maziac/lagmeter/Docs/Case.md

# Case

For the case a calculator like box with space for an LCD display has been chosen.
The buttons have been placed on the top.
An USB-A connector is included for power supply and to flash the device.
Instead an independent power 5V power supply can be attached.
Furthermore the USB host connector has been placed in the front to connect an USB joystick.

In the back the cables and the phot sensor can be packed.

In order to fit everything in the USB connector and the power supply connector have been removed from the Arduino.
The USB connector on the USB shield has been left there. In parallel wires have been connected to a connector in the front.

The labelling was done with a SW called FrontDesign. You find it [here](../HW/Panel.pfd).

# Hint

Use a white or gray case instead of a black one.
The labeling will be much easier because you can print black on a transparent foil with a laser printer.

# Finalized

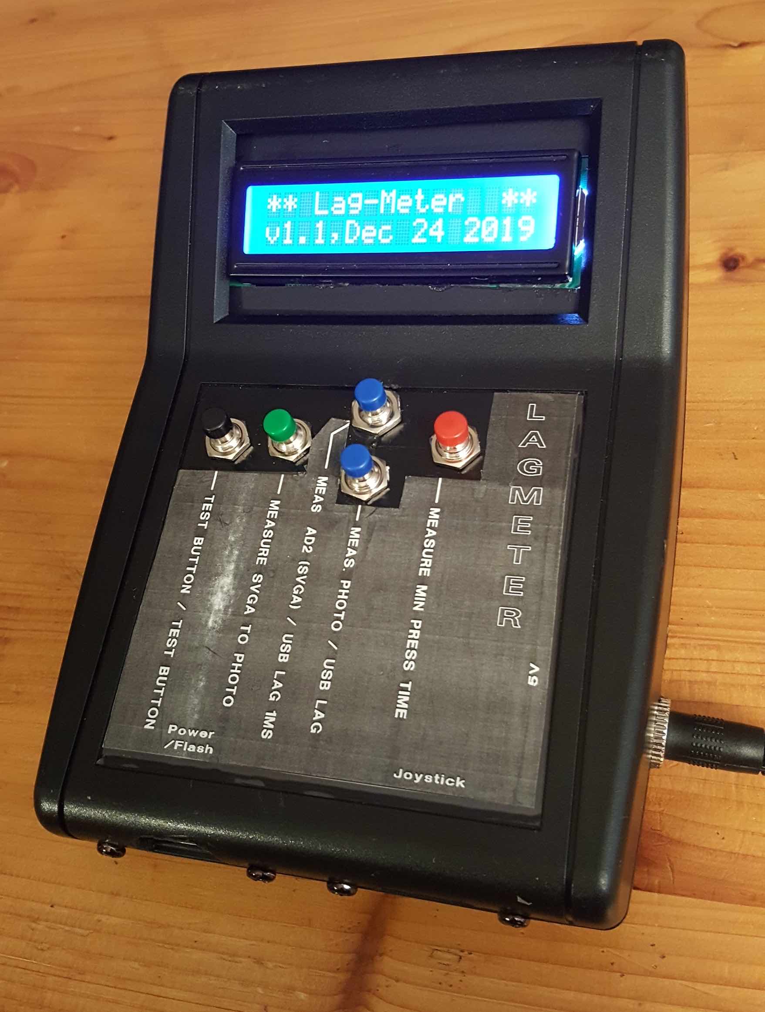
[picture p13: Docs/Images/Case/case_total1.jpg]

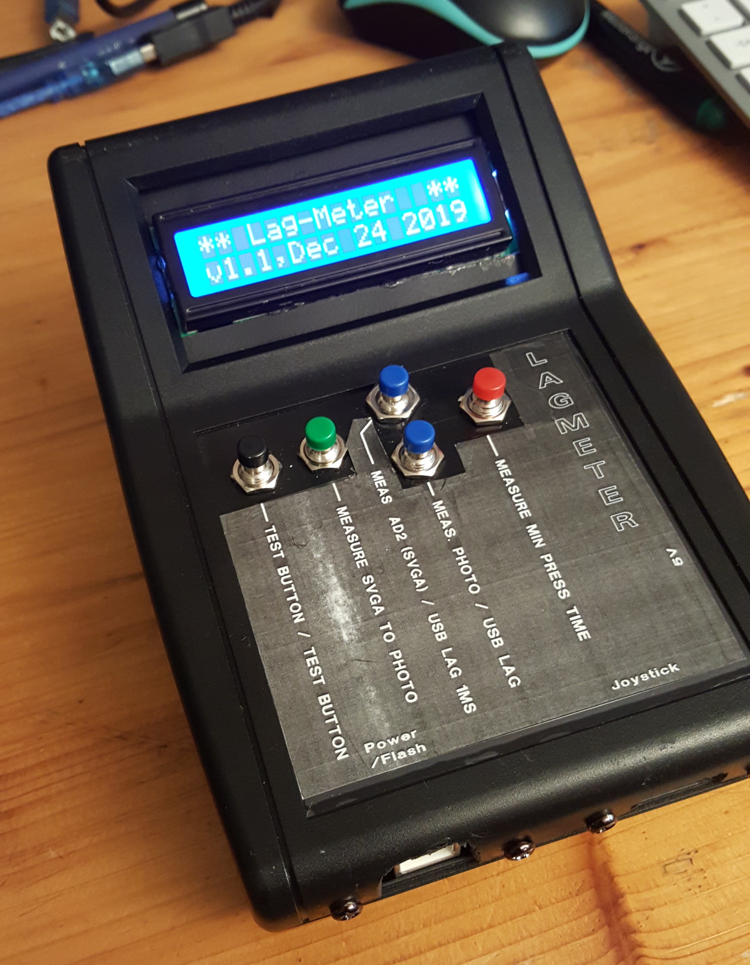
[picture p14: Docs/Images/Case/case_total2.jpg]

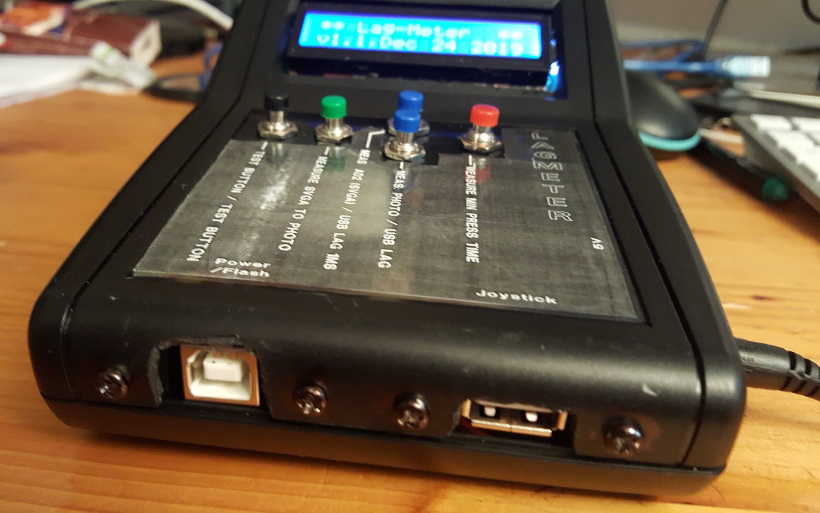
[picture p15: Docs/Images/Case/case_front.jpg]

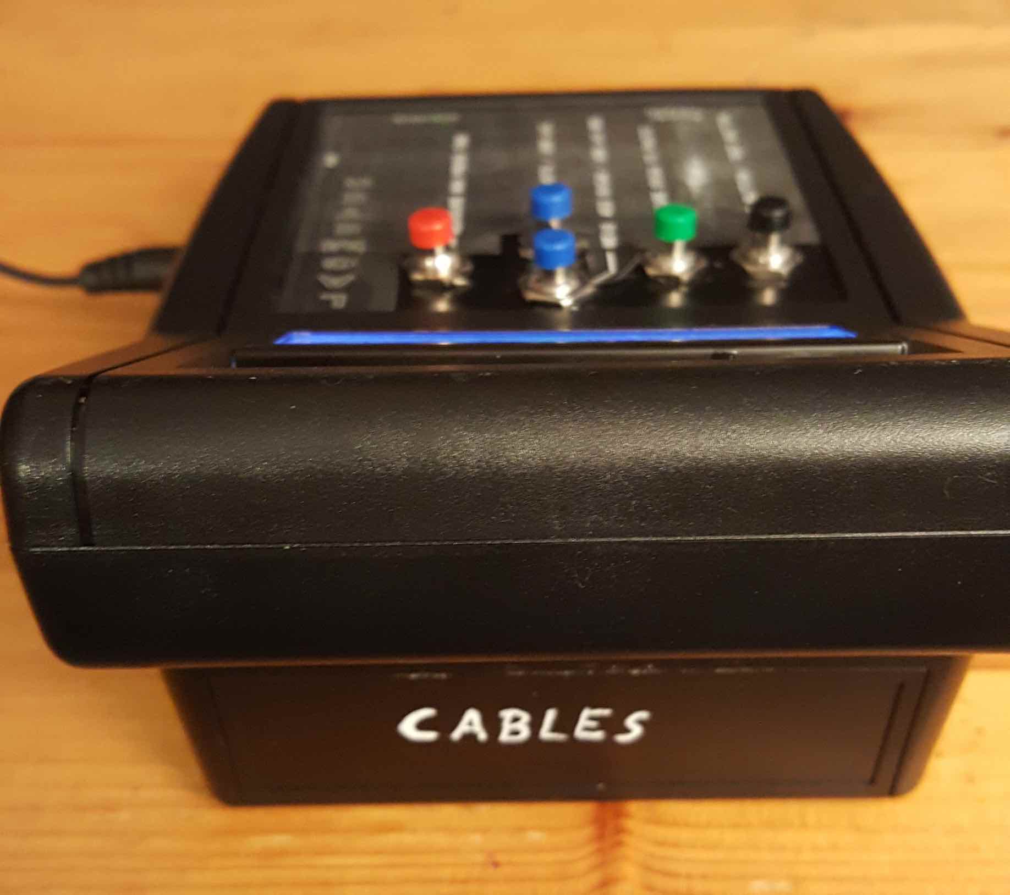
[picture p16: Docs/Images/Case/case_back.jpg]

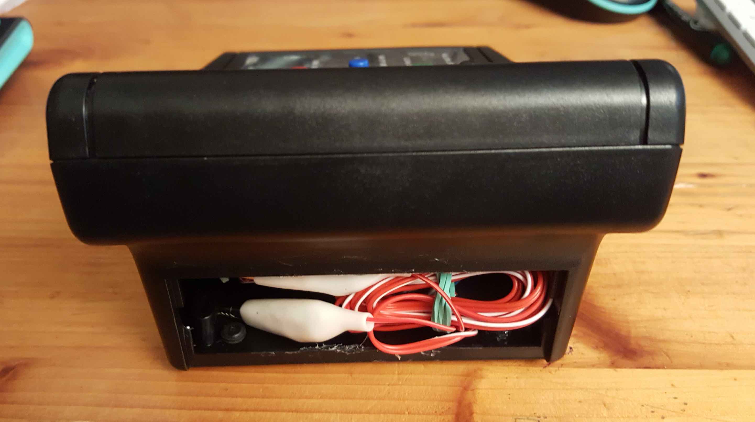
[picture p17: Docs/Images/Case/case_back_open1.jpg]

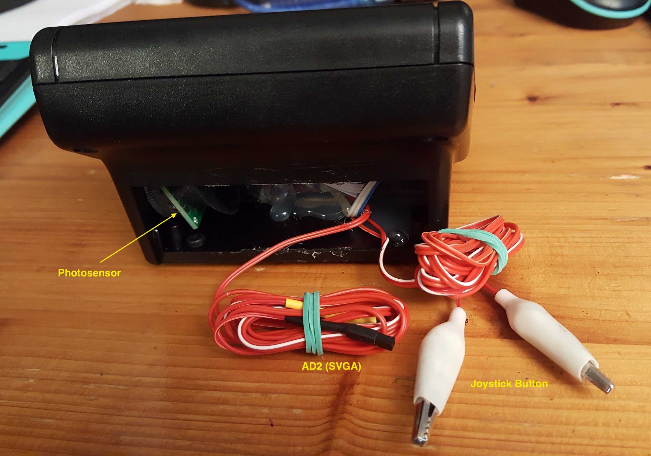
[picture p18: Docs/Images/Case/case_back_open2.jpg]

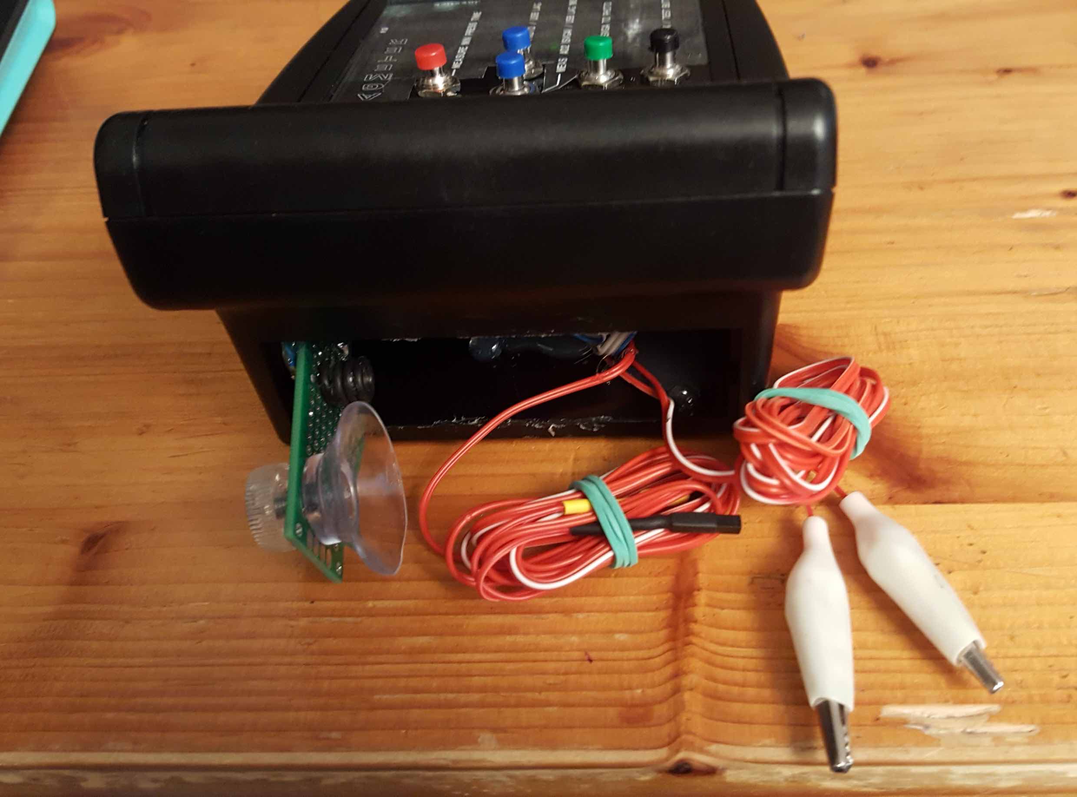
[picture p19: Docs/Images/Case/case_back_open3.jpg]

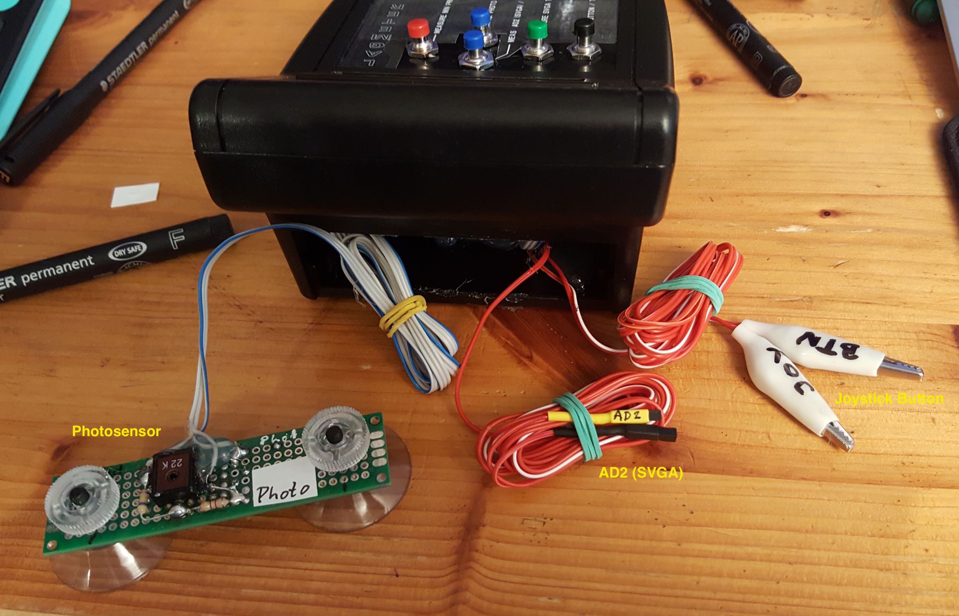
[picture p20: Docs/Images/Case/case_back_open4.jpg]


# Assembly

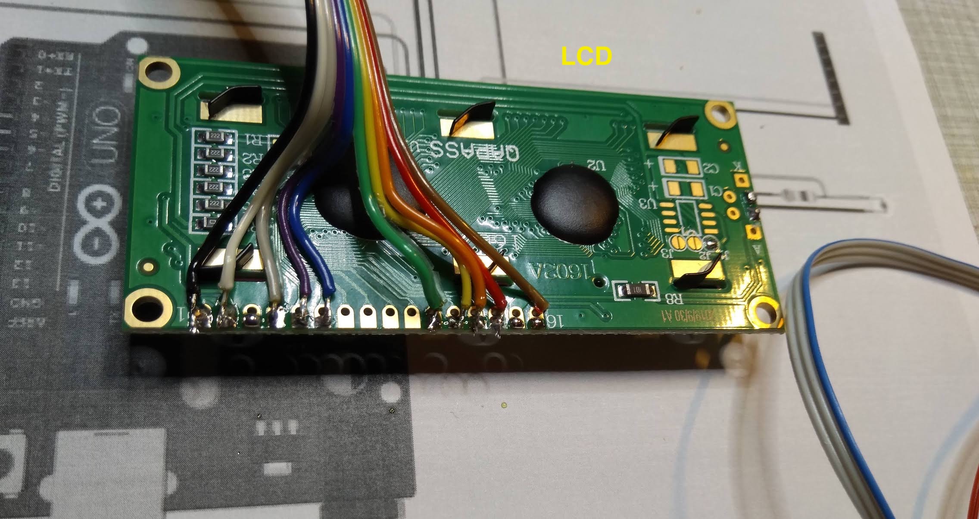
[picture p21: Docs/Images/Case/assembly_lcd1.jpg]

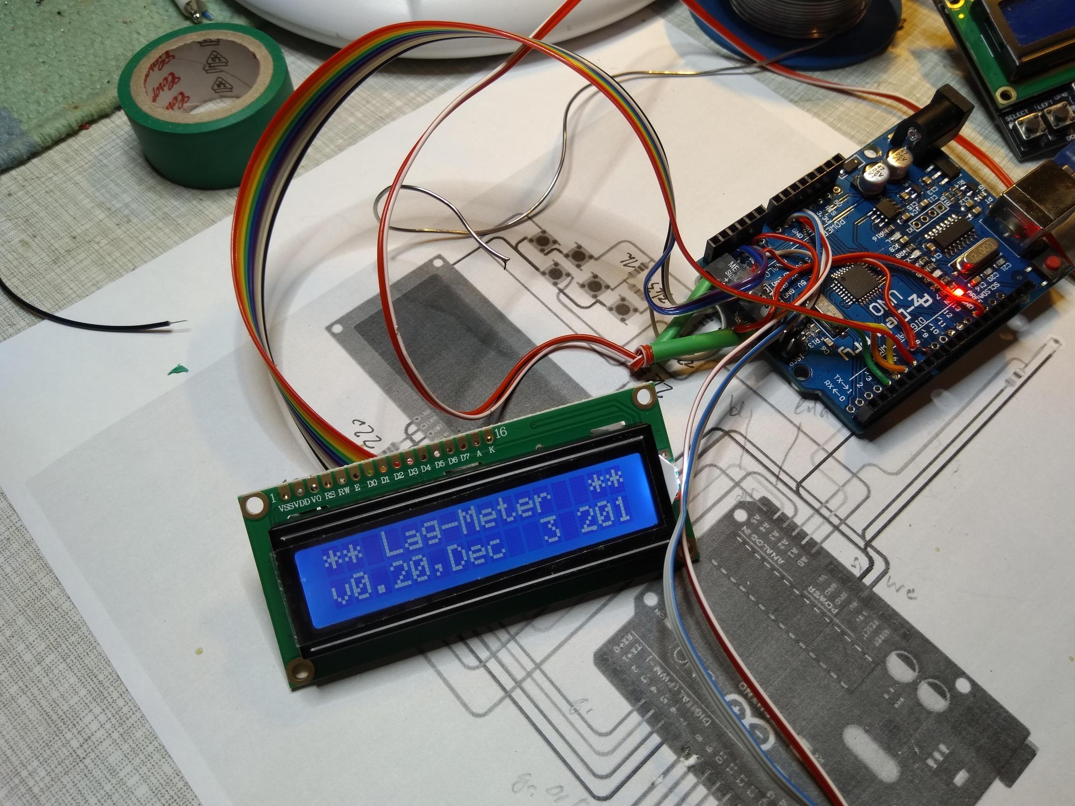
[picture p22: Docs/Images/Case/assembly_lcd2.jpg]

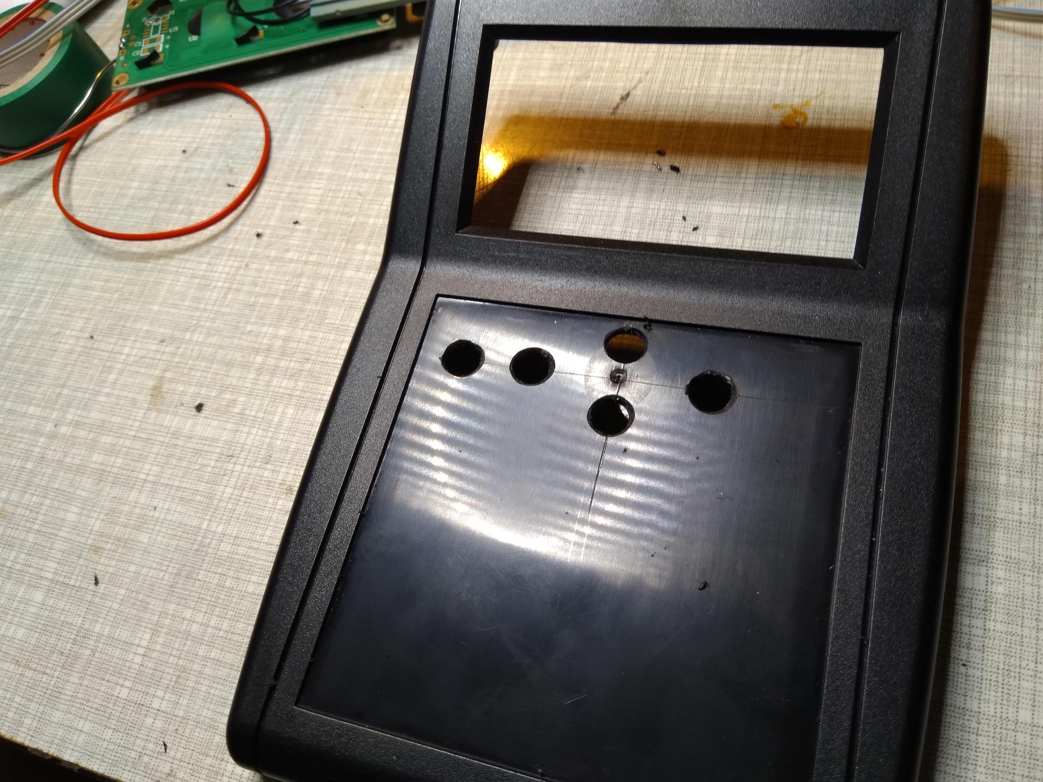
[picture p23: Docs/Images/Case/assembly_case_top_holes.jpg]

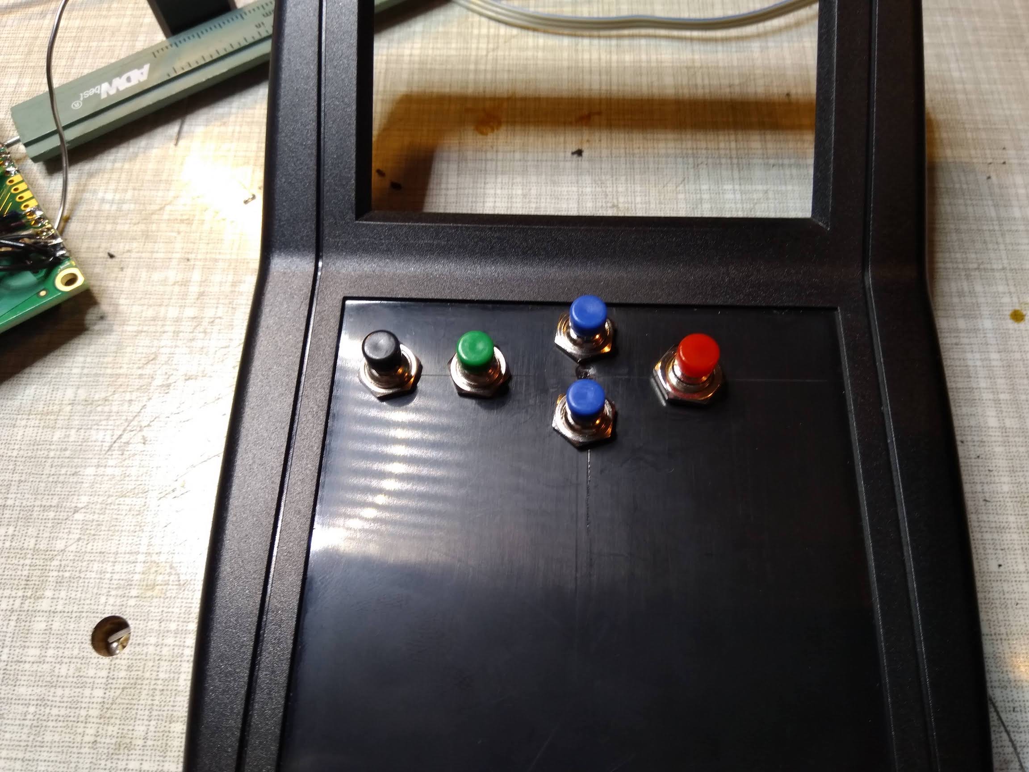
[picture p24: Docs/Images/Case/assembly_case_top_buttons.jpg]

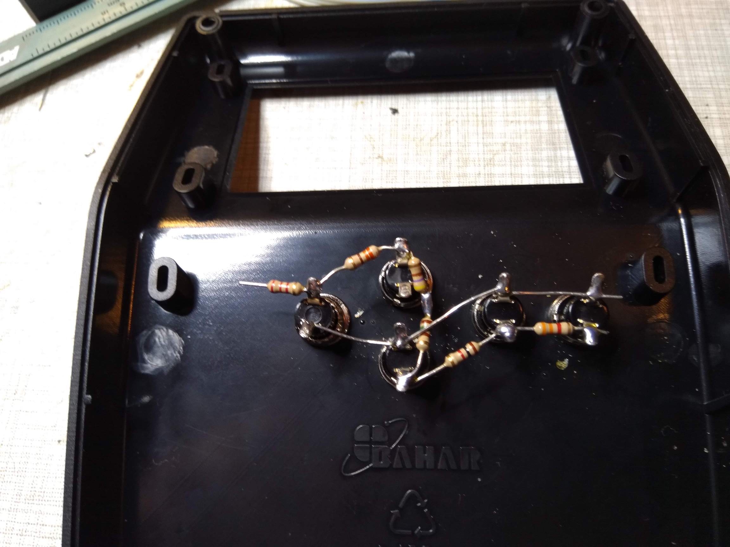
[picture p25: Docs/Images/Case/assembly_buttons.jpg]

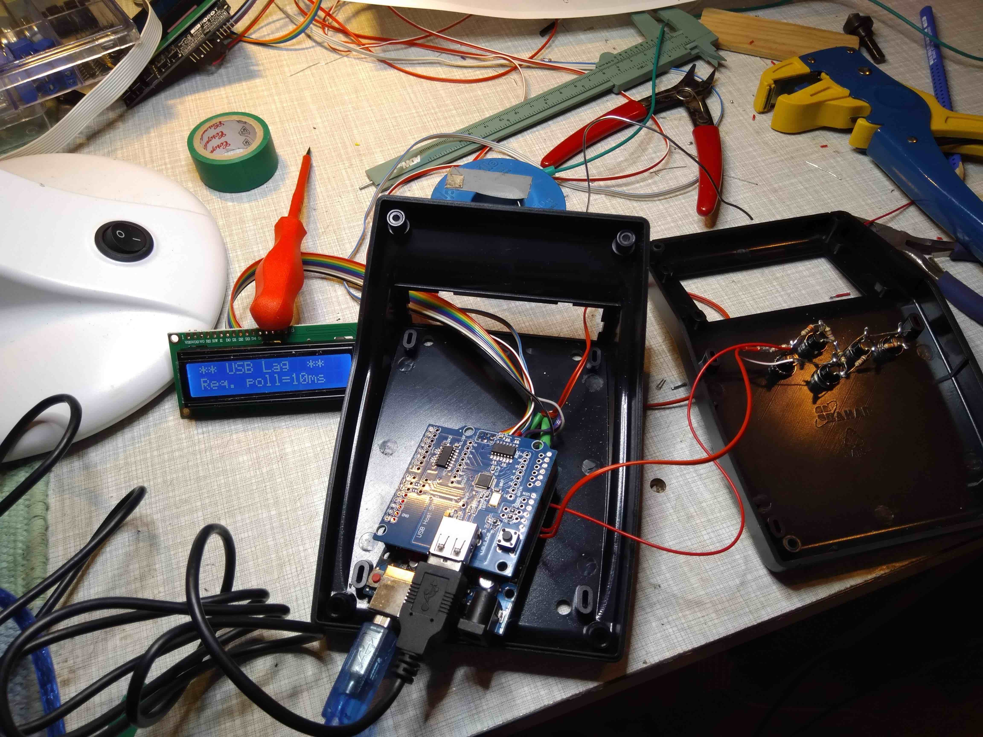
[picture p26: Docs/Images/Case/assembly_buttons_test.jpg]

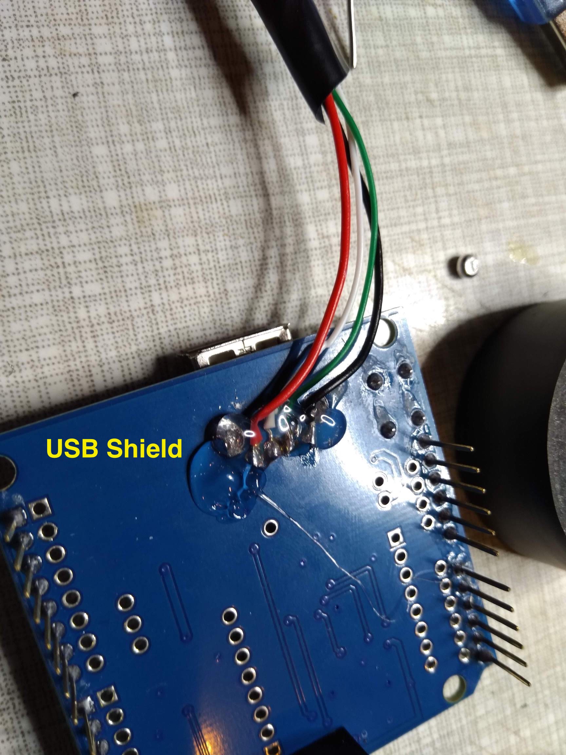
[picture p27: Docs/Images/Case/assembly_usb_shield_wires.jpg]

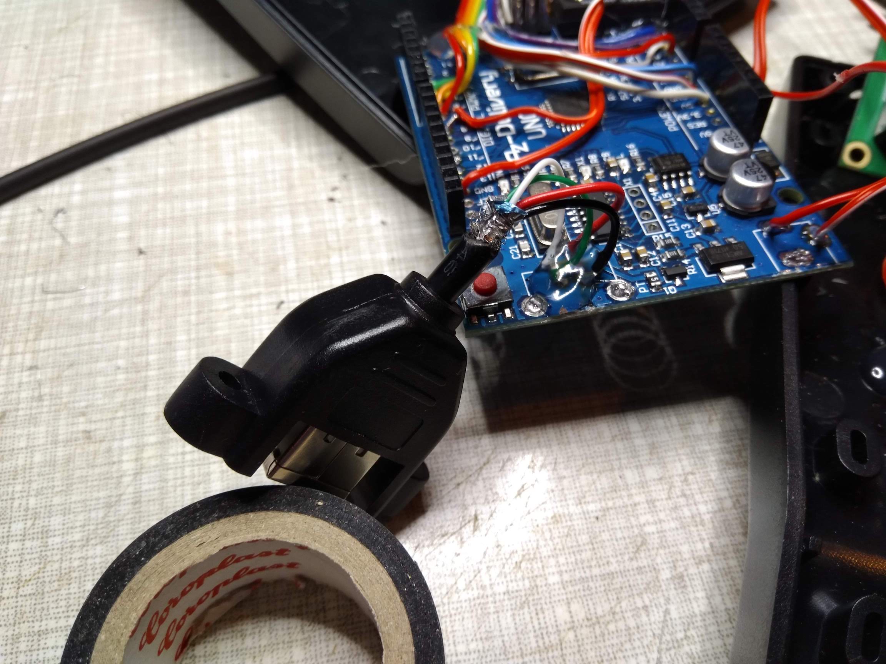
[picture p28: Docs/Images/Case/assembly_arduino_usb_connector.jpg]

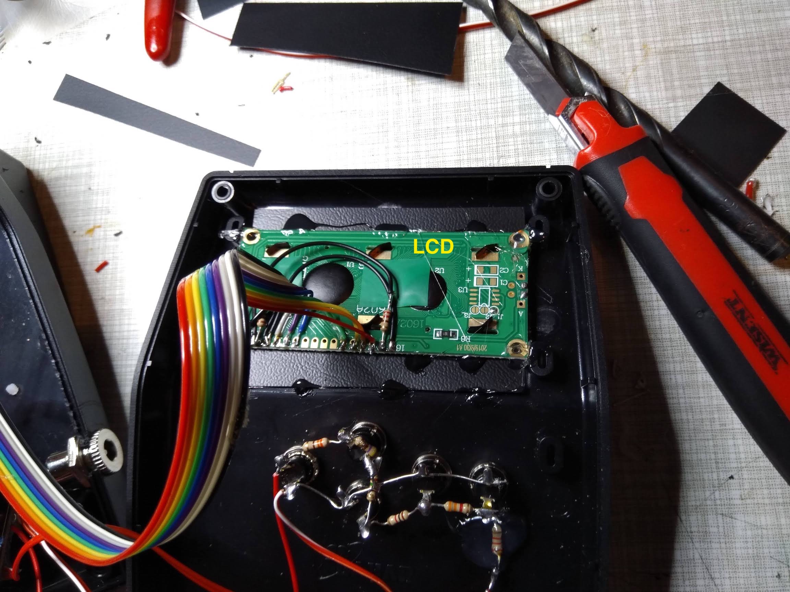
[picture p29: Docs/Images/Case/assembly_lcd_case1.jpg]
