maziac/lagmeter/Docs/Images/Case/case_back_open0.jpg

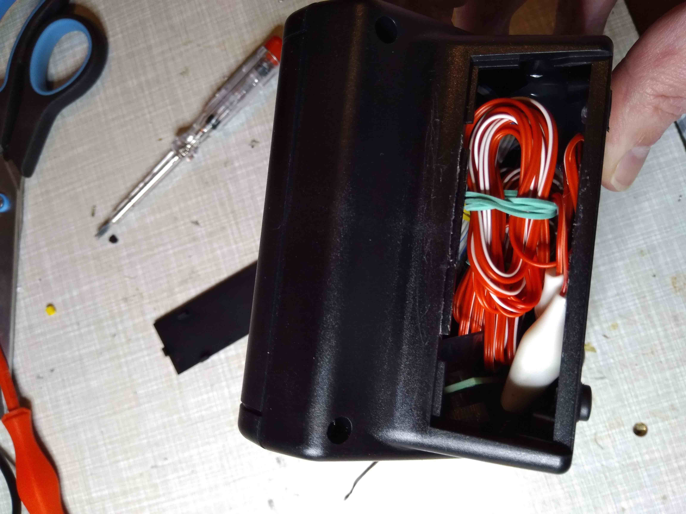
Docs/Images/Case/case_back_open0.jpg
