maziac/lagmeter/Docs/Images/Case/case_top.jpg

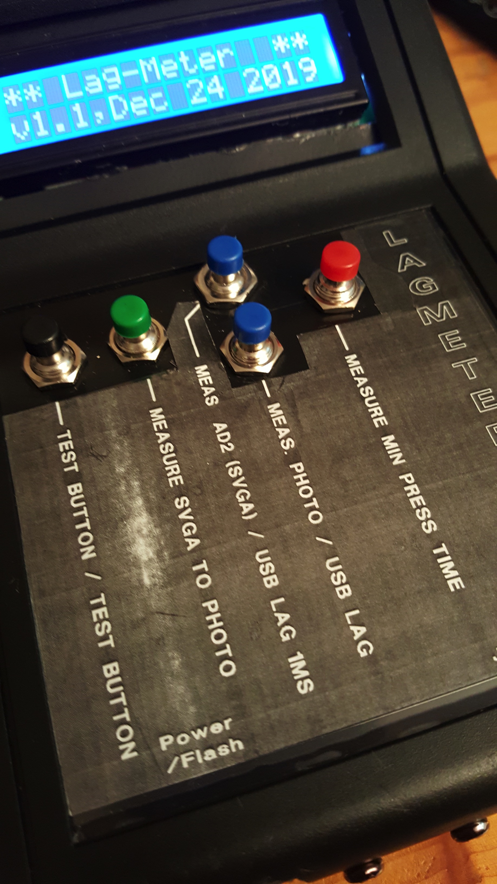
Docs/Images/Case/case_top.jpg
