maziac/lagmeter/Docs/Images/Readme/button_leaf.jpg

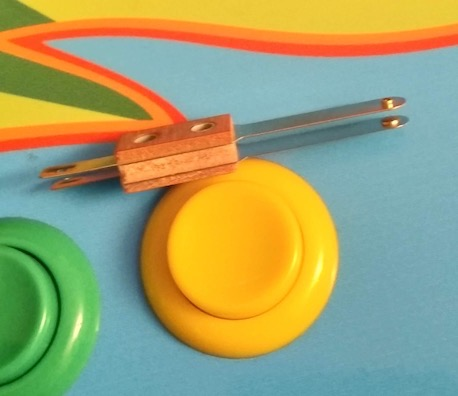
Docs/Images/Readme/button_leaf.jpg
