maziac/lagmeter/Docs/Images/Readme/button_leaf_press_2.BMP

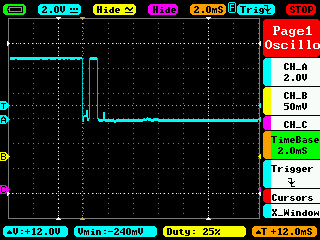
Docs/Images/Readme/button_leaf_press_2.BMP
