maziac/lagmeter/Docs/Images/Readme/button_leaf_rapid_fire.BMP

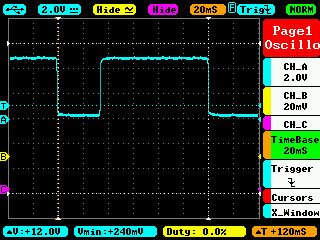
Docs/Images/Readme/button_leaf_rapid_fire.BMP
