maziac/lagmeter/Docs/Images/Readme/button_leaf_release.BMP

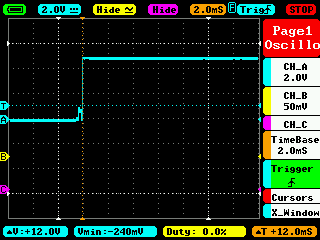
Docs/Images/Readme/button_leaf_release.BMP
