maziac/lagmeter/Docs/Images/Readme/button_leaf_smallest_14ms.BMP

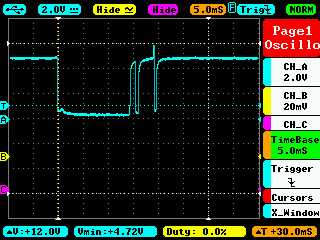
Docs/Images/Readme/button_leaf_smallest_14ms.BMP
