maziac/lagmeter/Docs/Images/Readme/button_leaf_smallest_23ms.BMP

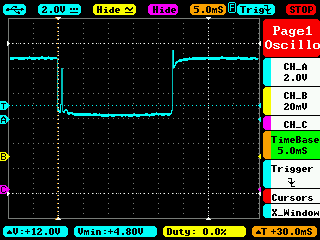
Docs/Images/Readme/button_leaf_smallest_23ms.BMP
