maziac/lagmeter/Docs/Images/Readme/button_micro.jpg

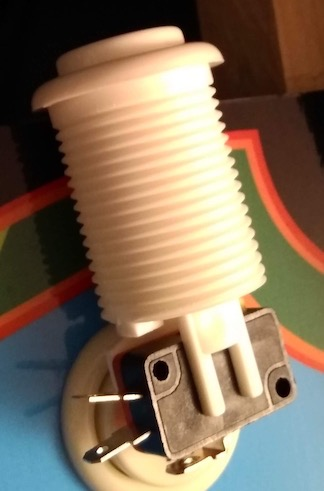
Docs/Images/Readme/button_micro.jpg
