maziac/lagmeter/Docs/Images/Readme/button_micro_bounce.BMP

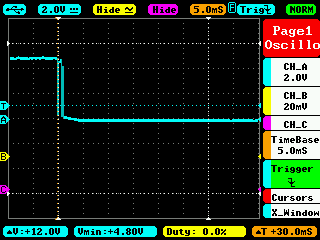
Docs/Images/Readme/button_micro_bounce.BMP
