maziac/lagmeter/Docs/Images/Readme/button_micro_smallest_45ms.BMP

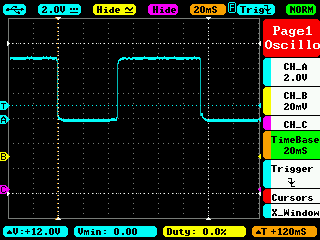
Docs/Images/Readme/button_micro_smallest_45ms.BMP
