maziac/lagmeter/Docs/Images/Readme/button_micro_smallest_70ms.BMP

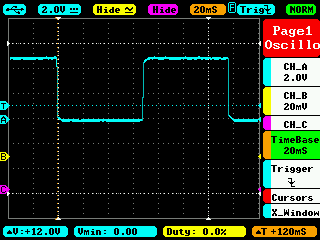
Docs/Images/Readme/button_micro_smallest_70ms.BMP
