maziac/lagmeter/Docs/Images/Readme/joystick_leaf.jpg

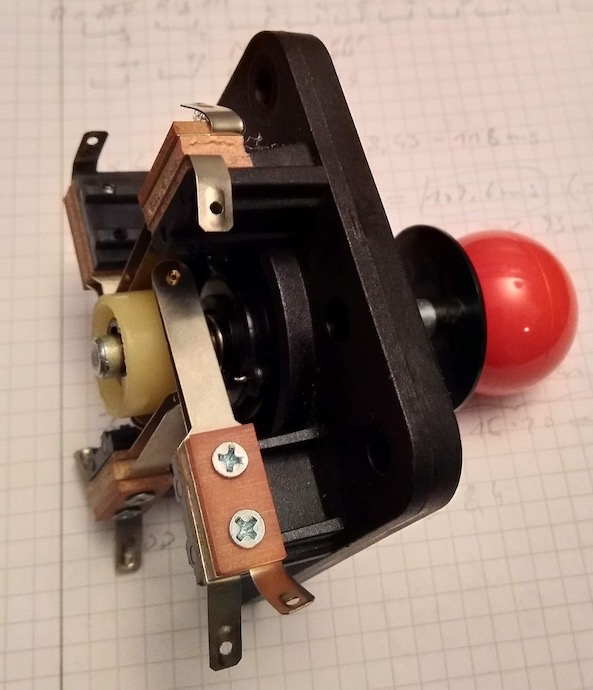
Docs/Images/Readme/joystick_leaf.jpg
