maziac/lagmeter/Docs/Images/Readme/joystick_leaf_smallest_50ms.BMP

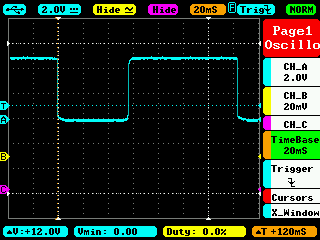
Docs/Images/Readme/joystick_leaf_smallest_50ms.BMP
