maziac/lagmeter/Docs/Images/Readme/wavedrom_polling_2.jpg

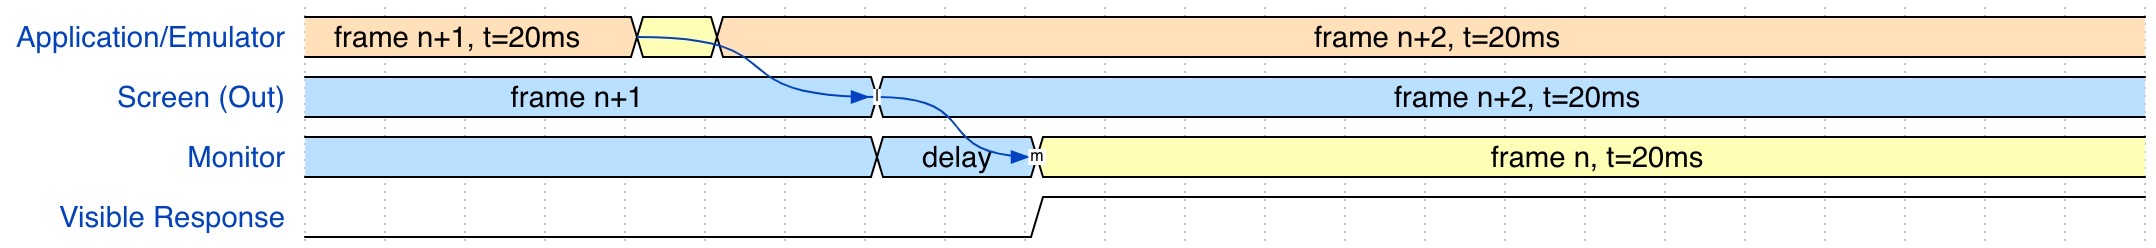
Docs/Images/Readme/wavedrom_polling_2.jpg
