maziac/lagmeter/Docs/Images/Case/assembly_case_cable_space.jpg

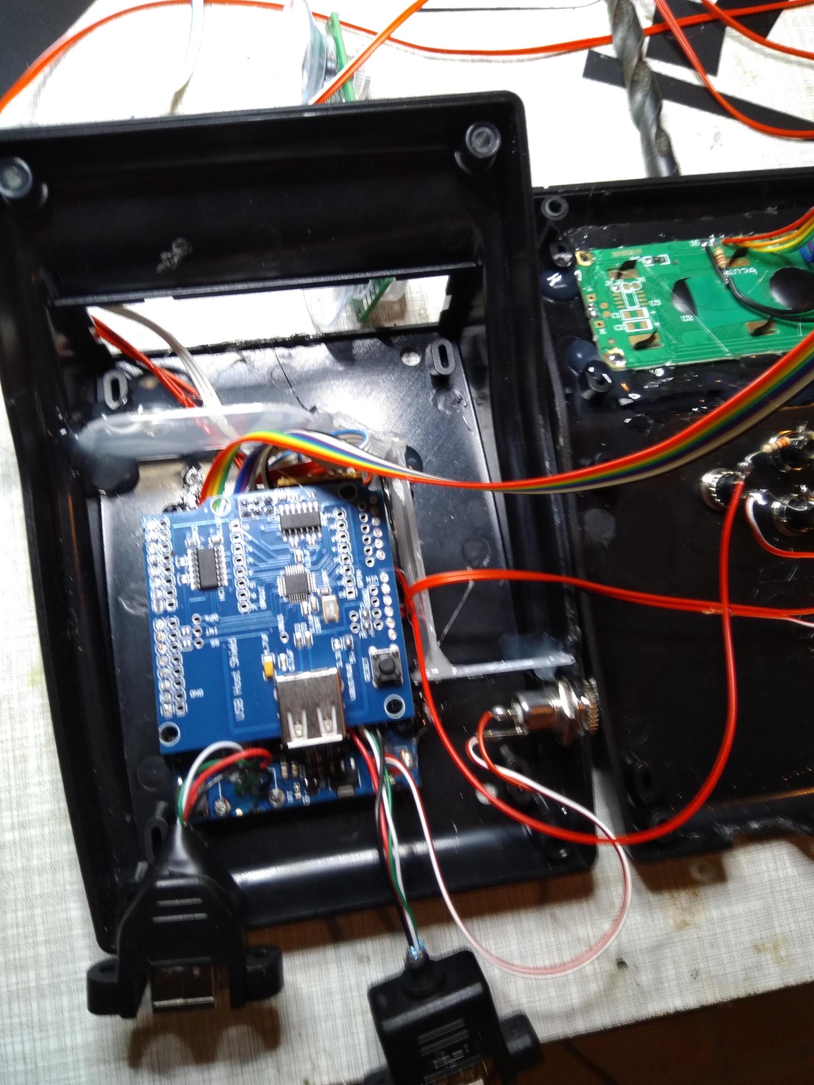
Docs/Images/Case/assembly_case_cable_space.jpg
