maziac/lagmeter/Docs/LagMeasurements.ods

Sheet: Total
Lag Measurements.
 |  | Lag Measurements.
HW Configuration | SW Configuration | Date | SW version | TotalMin/ms | TotalMax/ms | Min/ms | Max/ms | Min/ms | Max/ms | Min/ms | Max/ms | Min/ms | Max/ms | Min/ms | Max/ms
NUC, Button, EIZO-SVGA | Linux, MAME, fullscreen | 27. Aug 19 | 27. Aug 19 | 96 | 153 | 98 | 149 | 98 | 154 | 97 | 150 | 91 | 167 | 95 | 146
NUC, Button, EIZO-SVGA (1) | Linux, jstest | 27. Aug 19 | 27. Aug 19 | 66 | 100 | 66 | 100 | 67 | 101 | 71 | 100 | 64 | 100 | 63 | 99
NUC, Button, EIZO-SVGA (2) | Linux, jstest | 28. Aug 19 | 27. Aug 19 | 67 | 111 | 70 | 106 | 64 | 115 | 67 | 109 | 68 | 106 | 66 | 118
NUC, Button, EIZO-DVI (1) | Linux, jstest | 28. Aug 19 | 27. Aug 19 | 74 | 117 | 74 | 113 | 73 | 118 | 72 | 122 | 74 | 110 | 76 | 124
NUC, Button, EIZO-DVI (2) | Linux, jstest | 28. Aug 19 | 27. Aug 19 | 75 | 118 | 77 | 124 | 75 | 118 | 73 | 120 | 78 | 110 | 72 | 119
NUC, Button, BenQ-DVI (1) | Linux, jstest | 28. Aug 19 | 27. Aug 19 | 42 | 83 | 44 | 81 | 41 | 78 | 40 | 76 | 41 | 89 | 43 | 92
NUC, Button, BenQ-DVI (2) | Linux, jstest | 28. Aug 19 | 27. Aug 19 | 46 | 87 | 45 | 84 | 46 | 94 | 45 | 93 | 49 | 85 | 44 | 81
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
