maziac/lagmeter/(list of files, drawings)

Other design files:
Test/ZXLagTest/artwork/spec128/default.lay
