maziac/lagmeter/(commit log)

2019-08-25 Wait on photo sensor changed implemented.
2019-08-25 Test sensor.
2019-08-25 Simulated code with calibration and ranges.
2019-08-28 Added measurements spreadsheet.
    [LagMeasurements.ods]
2019-08-29 Radme added.
    [LagMeasurements.ods]
2019-08-29 "Test" now additionally toggles the stimulated button.
    [LagMeasurements.ods]
2019-08-29 Measured return time changed to unsigned.
    [LagMeasurements.ods]
2019-08-31 Button state now shown.
2019-08-31 More measurements (usblag).
    [LagMeasurements.ods]
2019-09-01 LCD Keypad shield: Buttons reconfigured.
2019-09-01 New pin configuration. USB Host shield can be used in parallel.
2019-09-02 Increased safety margin.
    [LagMeasurements.ods]
2019-09-04 ZX readme updated.
    [LagMeasurements.ods]
2019-09-04 More SVGA tests.
    [LagMeasurements.ods]
2019-09-05 Button for test SVGA to monitor.
2019-09-05 Measurement: SVGA to monitor.
    [LagMeasurements.ods]
2019-09-07 usblag generally working from LCD keypad shield button.
2019-09-07 Printing changed to test reaction of usb controller.
2019-09-08 PULLUP vor SVGA input pin.
2019-09-08 Enabled switching also for XBOX controller.
2019-09-10 Using a faster ADC osciallator setting to reach accuracy of 1ms.
    [LagMeasurements.ods]
2019-09-13 USB requested poll interval is shown.
    [LagMeasurements.ods]
2019-09-15 Output of press time through serial.
    [LagMeasurements.ods]
2019-09-22 More measurements.
    [LagMeasurements.ods]
2019-09-22 Updated schematics.
    [LagMeasurements.ods]
2019-09-25 Corrected measureMinPressTime
    [LagMeasurements.ods]
2019-09-27 XLagTesdt added
    [default.cfg, spec128.cfg]
2019-10-03 More documentation.
    [LagMeasurements.ods]
2019-11-25 Doc update.
    [LagMeasurements.ods]
2019-11-26 'Reset' when swtiching from USB mode to normal mode.
    [LagMeter.ino, USBHIDJoystick.ino]
2019-11-27 usblag: button on/off.
2019-12-01 Serial print removed in HID functions.
2019-12-03 HID: axes ignored for measurements, only buttons.
2019-12-24 Button assignment changed.
2019-12-24 Buttons changed again.
2019-12-28 Case documentation added.
2020-01-05 New measurements added.
    [LagMeasurements.ods]
2020-01-06 Adjusted level for button.
2020-01-11 Added rotation artwork file to test also rotated setup.
    [default.lay]
2020-01-12 Measurements with 32 inch AOC monitor.
    [LagMeasurements.ods]
2020-07-09 Raspi 4 measurements added.
    [LagMeasurements.ods]
2020-07-09 Added run-ahead results.
    [LagMeasurements.ods]
2020-07-10 More measurements with run-ahead etc.
    [LagMeasurements.ods]
2021-03-22 Added ATMega32U4 measurents. (DaemonBite-Arcade-Encoder)
2021-03-22 Added MISTer measurements.
    [LagMeasurements.ods]
2022-02-15 Change to calibration for a specific button.
2022-02-15 Optimized calibration.
2022-02-16 More serial printing.
2022-02-17 Fixed restoring of usb poll intervall after forced 1 ms measurement.
    [LagMeter.ino, Measure.h]
